FranzKugler/zynq-astro-guider/golden_model/rotation_sensitivity.png

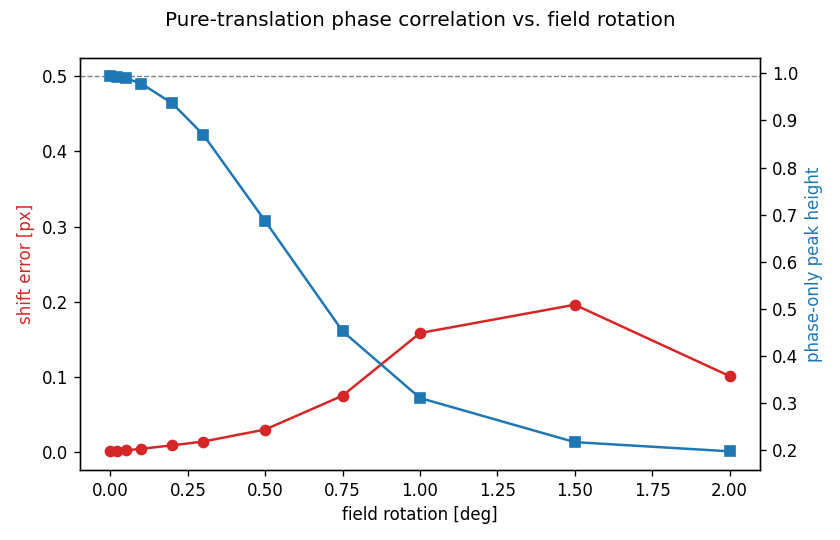
golden_model/rotation_sensitivity.png
