FranzKugler/zynq-astro-guider/(commit log)

2026-06-03 golden_model: fixed-point estimate_shift (BFP FFT, 12-bit) — validation stage 2
    Bit-accurate spec for the FPGA datapath, same interface as the float golden
    model and tested to reproduce it on identical inputs:
    - 12-bit input, Hann folded in as a fixed-point coefficient
    - separable radix-2 DIT FFT/IFFT in block floating point (int64 mantissa +
    shared block exponent, per-stage round+saturate) — models the Xilinx FFT IP
    - quantized twiddles; fixed-point conj(F)*G cross-power
    - phase-only normalization as a CORDIC (angle quantized to cordic_bits, unit
    vector to unit_bits)
    - integer argmax; parabolic subpixel stays in float (runs on the PS)
    - FixedConfig exposes all bit widths for FFT-IP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
2026-06-03 docs: record fixed-point bit-width choices with sweep evidence
    fixed_point.md documents the FixedConfig defaults and backs them with an
    error-vs-float sweep: mant_bits is the only accuracy/peak-SNR knob (18 native),
    twiddle_bits is flat at N=64 (don't trim — grows with N), cordic/unit converge
    by ~8 bits. Plus M4 caveats (re-sweep at real frame size). Link from
    architecture.md.
2026-06-03 hdl: cross-power stage, bit-exact cosim (conj(F)*G + BFP rescale)
    CrossMul (per-element complex conj-multiply, exact), ShiftFromMax (block max ->
    BFP shift via bit_length priority encoder), BfpRescale (variable-shift convergent
    round + saturate). fixed.py gains round_shift_var_expr, saturate_expr, bit_length.
    Cosim: each block bit-exact over random vectors (incl. edges/ties), plus an
    end-to-end check on real FFT outputs from the model — reproduces the model's
    cross-power + _bfp_rescale exactly (exercises a 33-bit block max -> sh=16). The
    streaming block-max reducer is deferred to the top-level stream wrapper.
2026-06-04 hdl: phase-only normalization via two-pass CORDIC (tolerance-cosim'd)
    R/|R| as vectoring (extract angle) + rotating (regenerate gain-compensated unit
    vector) CORDIC, combinational unrolled. Two-level verification:
    - cordic_ref.py: bit-accurate fixed-point CORDIC = the HW spec; the Amaranth
    PhaseOnly is cosim'd BIT-EXACT against it (random + edges + tiny + real data).
    - cordic_ref vs the float golden model: TOLERANCE, max <=8 LSB on the unit
    vector (the model's float atan2 can't be matched bit-for-bit).
    Guard bits gv=14 sized so tiny |R|~1 bins -- whose angle the float model still
    resolves exactly -- stay within a few LSB (490 -> 4 worst case). Pipelining the
    two passes is a later synthe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
2026-06-04 hdl: streaming block-max reducer (BFP first pass)
    BlockMax tracks max(|re|,|im|) over a cross-power block (i_first resets, o_max
    valid after the last element), feeding ShiftFromMax to close the BFP rescale.
    First sequential/clocked block — establishes the streaming cosim pattern.
    fixed.py gains abs_expr. Cosim bit-exact: running max over random blocks,
    mid-stream reset, and a real cross-power block.
2026-06-04 hdl: corner-turn buffer (transpose between FFT passes)
    CornerTurn streams an NxN frame in row-major and reads it back transposed via a
    ping-pong double buffer (write frame k+1 while reading frame k), one sample/cycle
    after a one-frame fill. For power-of-two N the transposed read address is the
    row-major address with its two halves swapped. Opaque payload (re|im).
    Cosim bit-exact vs numpy transpose (N=4, N=8) and a continuous-throughput check
    (output count == frames * N*N, ping-pong sustains no gaps).
2026-06-04 hdl: end-to-end pipeline cosim (all blocks chained, FFT stubbed by model)
    cosim.py estimate_shift_hw drives the real Amaranth blocks (WindowMul, CrossMul,
    BlockMax, ShiftFromMax, BfpRescale, PhaseOnly) through pysim in the model's
    dataflow, with _fft2d standing in for the FFT IP, and runs peak+parabolic on the
    result. Same interface as the model.
    End-to-end: recovers known shifts to ~0.005px and tracks estimate_shift_fixed to
    4 decimals (HW vs model delta ~0) -- the CORDIC phase-only divergence does not
    move the shift estimate. Windowed path exercises WindowMul. Non-synthesizable
    harness; the synthesizable top-level + FFT-IP wrapper come with the Vivado flow.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
2026-06-04 hdl: validate FFT IP gen against Vivado 2025.2; fix Tcl + wrapper
    Ran gen_fft_ip.tcl in Vivado 2025.2: all CONFIG.* properties accepted, IP
    generates clean. Generated port list confirms the wrapper's map exactly --
    s/m_axis_data_tdata 48b (24b byte-aligned fields), s_axis_config_tdata 8b,
    m_axis_data_tuser 8b (BFP block exponent).
    Fixes from the run:
    - drop CONFIG.ovflo (disabled under BFP -> warning); block exponent rides on
    m_axis_data_tuser instead.
    - wire the m_axis_status channel with tready tied high so the IP can't stall on
    it (unused under BFP).
2026-06-04 hdl: FFT IP xsim cosim green (DFT verified up to common frame rotation)
    Drive the generated Xilinx FFT IP in Vivado xsim and check it against a
    numpy DFT. The pipelined-streaming core frames at a fixed phase offset from
    the cold-start testbench (captured frame == DFT of a +1 cyclic shift); that
    offset is a common cyclic shift and cancels in the cross-power conj(F_ref)*F_img,
    so it is benign for the guider. The cosim therefore certifies the transform up
    to that single common rotation: rotation-invariant magnitude spectrum plus a
    best-fit-over-shifts phase check, both within tolerance (~1e-5 here).
    Harness: launch_simulation keeps an interactive xsim kernel alive after $finish,
    so Vivado neve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
2026-06-04 hdl: start DDR-streaming top-level — AXI-S phase-stage kernels
    Begin the synthesizable top-level stream assembly. Frames live in PS DDR3
    (whole-field FFT arrays exceed the XC7Z020's BRAM), so the PL is AXI-Stream
    compute kernels driven by PS+DMA; the inter-pass transpose becomes a DMA
    addressing pattern rather than the on-chip corner-turn.
    - stream.py: minimal AXI4-Stream interface (valid/ready/first/last/payload)
    via lib.wiring, the shared dialect for all kernels.
    - phase_stage.py: the cross-power phase stage split into the two DDR passes
    global BFP requires:
    CrossPower pass 1 — join F,G, emit exact conj(F)*G, track frame block max
    RescalePhase pass 2 — BFP-rescale by s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
2026-06-04 hdl: window streaming kernel (WindowStream)
    First datapath kernel: AXI-Stream Hann window joining a real sample stream with
    a coefficient stream (the model's w_int = round(hann2d * 2**window_bits)). The
    coefficients are session-constant, so the PS replays them as a second DMA stream
    rather than holding an on-chip coef ROM -- keeps everything DDR-streamed and
    bit-exact to the model by construction. Wraps the existing WindowMul.
    test_window.py: WindowStream over a real frame == the model's windowed
    _quantize_input. Full suite 21 passed.
2026-06-04 hdl: FFT-pass kernel (FftPass) + behavioral FftStub
    FftPass wraps the time-shared FFT IP with the framing the synthesizable top
    needs: load the transform direction once (config), assert tlast at each N-point
    row boundary, reframe the natural-order output as an N x N frame stream, and sum
    the per-row BFP block exponents (TUSER). The 2-D FFT is two FftPass passes with a
    DMA transpose between them, so the on-chip corner-turn is unneeded at whole-field
    sizes.
    FftStub is a sim-only identity skid with the same AXI-S port surface as FftIP,
    injected via FftPass(core=...) so the framing/handshake/backpressure logic is
    pysim-testable; the transform itself stays xsim-verified (sim/fft_cosim.py).
    test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
2026-06-04 hdl: top-level PL assembly (PhaseCorrelatorPL)
    Assemble the synthesizable PL phase-correlation datapath. The one shared
    resource is the FFT IP, time-shared across all FFT/IFFT passes via a single
    FftPass endpoint the PS feeds repeatedly; the other kernels (window, cross-power,
    rescale/phase-only) get their own AXIS endpoints. PhaseCorrelatorPL instantiates
    them and exposes the stream endpoints + control (fft_inverse, rescale_sh) and
    status (xpower_max, fft_blk_exp_sum) as the PL's external contract for the Zynq
    block design + DMA channels. Module docstring documents the PS pass schedule.
    Elaborates to RTLIL with the fft_256 black box; test_top.py integration-cosims
    through the top with the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
2026-06-04 target: PS orchestration of the PL pass schedule + ModelBackend
    Start the on-board guiding app (guider_target). estimate_shift_pl runs the
    DDR-streaming pass schedule of guider_hdl.top.PhaseCorrelatorPL through a
    PLBackend seam: window -> FFT2(ref,img) -> cross-power + block max -> shift
    handoff -> rescale/phase-only -> IFFT2 -> peak. The PS owns input quantization,
    the block-max -> BFP-shift, and the argmax + parabolic subpixel; the 2-D FFT is
    done as pass -> transpose -> pass so the transposed (column-major DMA) read is
    explicit.
    - backend.py PLBackend ABC (one method per kernel pass) + shift_from_max
    - orchestrator.py estimate_shift_pl (mirrors fixed_point.estimate_shift)
    - model_back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
2026-06-04 docs: refresh CLAUDE.md milestones (M3/M4 + PS orchestration done)
    Repo layout, validation chain, and milestones were stale (M3 "in progress").
    Update to reality: golden + fixed-point models, the DDR-streaming PL datapath
    (kernels cosim'd, FFT IP xsim'd, top.py assembled), and the PS orchestration
    (guider_target, bit-exact vs the model via ModelBackend) are all done. Next (M5):
    integrated bitstream + on-board validation.
2026-06-04 docs: scope M5 (Vivado block design + bitstream integration)
    bitstream_integration.md: the M5 plan to put PhaseCorrelatorPL on the XC7Z020.
    Key points:
    - Deploy/iterate is over ssh (ikwzm fpga_manager + u-dma-buf); JTAG only for ILA
    or PS7 re-init. Notes the Zynq-7 PS7/FSBL caveat (confirm FCLK + AXI-HP path).
    - Block design: PS7 + 2x AXI-DMA + AXIS switches + AXI-Lite CSR-wrapped
    PhaseCorrelatorPL; one FFT IP time-shared across passes.
    - Transposes stay on the PS (orchestrator already does .T between fft passes), so
    every DMA transfer is contiguous -- no 2D/scatter-gather DMA.
    - Build flow (Amaranth->Verilog + FFT XCI -> create_bd.tcl -> bitstream/.xsa ->
    .bit.bin + DT overlay), ope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
2026-06-04 docs: lock M5 decisions (2 DMAs + AXIS switches, AXI-Lite CSR, 100 MHz, RTL)
    Confirmed the block-design forks: 2x AXI-DMA + PS-routed AXIS switches for data
    movement; an Amaranth AXI-Lite CSR wrapper around PhaseCorrelatorPL (one IP, one
    uio region); single 100 MHz FCLK; PhaseCorrelatorPL added as RTL via a Verilog
    wrapper (not package_ip).
2026-06-04 hdl: AXI-Lite CSR wrapper (PhaseCorrelatorTop)
    Wrap PhaseCorrelatorPL with a hand-rolled AXI-Lite slave so the whole PL is one
    IP: a single AXI-Lite control/status region + the AXIS data ports. This is the
    register map guider_target.UioBackend will poke (M5).
    - csr.py: AXILite signature; PhaseCorrelatorCsr (single-transaction AXI-Lite
    slave -- CTRL: fft_inverse + rescale_sh; STATUS: sticky xpower_done/fft_done
    W1C; latched xpower_max[37] (lo/hi), blk_exp_sum; ID magic for bitstream
    sanity); PhaseCorrelatorTop wires it to PhaseCorrelatorPL and passes AXIS through.
    - test_csr.py: control writes drive the datapath + read back, status strobes
    latch and clear, CTRL propagates through the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
2026-06-04 docs: record board state for M5 (runtime load works; driver follow-ups)
    Ran the read-only board check over ssh. fpga_manager is operating with fpga-full
    + overlay configfs -> runtime full-bitstream load via an overlay works, no
    BOOT.bin rebuild for loading. Follow-ups are all ssh-side: u-dma-buf not loaded,
    fclkcfg not loaded (set FCLK via overlay), CMA only 16 MB (bump for N=256), and
    choose generic-uio vs /dev/mem for the CSR. Task 1 resolved.
2026-06-04 hdl: AXIS-native IP boundary (FirstGen) — TLAST-only data ports
    AXI-DMA presents TLAST but no TFIRST, while CrossPower uses FIRST to reset its
    per-frame block-max. Regenerate FIRST inside the Amaranth top instead of in the
    block-design wrapper:
    - stream.py: AXIStream (valid/ready/last/payload, no FIRST) + FirstGen, which
    derives FIRST = first beat after reset / the beat after each LAST (one state
    bit, no data latency).
    - csr.py: PhaseCorrelatorTop now exposes AXIS-native data ports -- FirstGen on
    each input, FIRST dropped on outputs. The emitted top is TLAST-only, so the BD
    SystemVerilog wrapper becomes a pure port rename.
    - test_axis.py: FirstGen regenerates FIRST under backpress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
2026-06-04 bd: block design Tcl + Verilog AXI wrapper — validates
    bd/phase_correlator_axi.v renames the Amaranth top's flat iface__field ports to
    standard Xilinx AXI-Lite/AXIS (uniform 128-bit TDATA, payload in the low bits),
    with X_INTERFACE attributes so the BD infers the interfaces. Pure rename, no glue.
    bd/create_bd.tcl builds the block design: PS7 (GP0 control, HP0 for DMA, FCLK0
    100 MHz), 2x AXI-DMA (register-direct), 2x AXIS switch (PS-routed), control +
    memory SmartConnects, proc_sys_reset, and the IP module. `-tclargs bd` does
    create+validate (FFT IP skipped -- it's a black box deep in the RTL, not needed
    for validate_bd, so this is ~20 s); `-tclargs all` adds synth/impl/bitstream/.xsa.
    va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
    [phase_correlator_axi.v]
2026-06-04 bd: first timing-closed bitstream (FCLK 6 MHz)
    The phase-only CORDIC and cross-power are combinational (deep ~116 ns paths), so
    the datapath misses 100 MHz badly (WNS -106 ns). Make FCLK a tclarg and default
    it to 6 MHz: synth/impl/write_bitstream now closes timing (WNS +29.9 ns, hold
    met) and emits phase_corr_wrapper.bit + phase_corr.xsa. 6 MHz ~= 10 fps at N=256,
    plenty for guide-frame rates; pipelining the CORDIC to raise FCLK is a later
    throughput upgrade.
    vivado -mode batch -source bd/create_bd.tcl -tclargs all 256 6
2026-06-04 bd: device-tree overlay + finding — full bitstream drops PL-routed Ethernet
    phase_corr_overlay.dts (ikwzm dtbocfg): programs the bitstream into the
    fpga-full region + adds an fclkcfg node for FCLK_CLK0 (FCLK0 = clkc[15], set to
    ~6 MHz). The load path works (stage .dtbo, echo 1 > status; bootgen
    -process_bitstream bin loaded fine).
    But the first load took the board off the network: Ethernet is PS-GEM via EMIO
    through the PL (bank 35, MII), and our full bitstream doesn't route GEM->PHY.
    docs updated: bd/create_bd.tcl must add PS7 ENET0 EMIO + the bank-35 MII pin XDC,
    else the ssh-driven test is impossible (loading disconnects the link). Recovery
    from such a load = power-cycle (reloads BOOT.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
2026-06-05 bd: capture Z7-Lite bank-35 Ethernet MII pin map
    From the salvaged linux_sd design (axi_ethernetlite). The RTL8201F MII pins are
    the physical board wiring (txd/rxd to N15/M15/L15/M14, J14/K14/M18/M17; tx_en
    N16, tx_clk L14, rx_dv K18, rx_clk K17, mdc G14, mdio J15, phy_rst H20) and apply
    regardless of MAC. Needed so the phase-corr bitstream can drive the PHY and not
    kill the network on load.
    Note: linux_sd uses axi_ethernetlite (soft MAC); the board currently boots macb
    (PS-GEM EMIO) -- different MAC, same pins. MAC choice TBD (see next).
2026-06-05 bd: GEM-EMIO Ethernet proven on-board (minimal test bitstream)
    From-scratch PS7 ENET0-via-EMIO -> RTL8201F 100M MII, built and loaded on the
    board: macb kept the link up SEAMLESSLY through the reconfig (link never dropped,
    ssh survived, ping 0% loss). This unblocks ssh-driven on-board validation.
    - create_enet_test.tcl: minimal BD (PS7 + ENET0 EMIO, no datapath), expose GMII +
    MDIO, build via the custom top.
    - enet_test_top.v: maps GMII EMIO -> MII (lower nibble; PHY-sourced tx/rx clocks
    into GMII_TX_CLK/RX_CLK; tie tx_er/col/crs/rx_er; MDIO IOBUF; phy_rst_n high).
    - enet_test_pins.xdc: bank-35 MII pin + 25 MHz MII clock constraints.
    Next: fold the same ENET0-EMIO block into bd/create_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
2026-06-05 bd: integrate GEM-EMIO Ethernet into the phase-corr bitstream
    Fold the proven ENET0-EMIO block into create_bd.tcl: PS7 ENET0 on EMIO + MDIO,
    GMII/MDIO made external, and a custom top (phase_corr_top.v, same structure as
    the validated enet_test_top.v) maps GMII -> bank-35 MII + MDIO IOBUF and passes
    DDR/FIXED_IO. So loading the full datapath bitstream keeps macb/ssh alive. BD
    validates with Ethernet added; full build next.
    [phase_corr_top.v]
2026-06-05 bd: full datapath + Ethernet bitstream builds (timing closed)
    Make PS7 FIXED_IO + DDR external via apply_bd_automation so the custom top
    (phase_corr_top.v) can pass them through (the earlier make_wrapper flow promoted
    them implicitly; the custom top needs them as real BD ports). Full build now
    synthesizes, places, routes and closes timing (WNS +29.2 ns, hold met) -> the
    phase-correlation datapath @ 6 MHz + GEM-EMIO Ethernet in one bitstream.
2026-06-05 bd: phase-corr datapath alive on board (CSR ID reads, network up)
    Loaded the full datapath+Ethernet bitstream on the Zynq via the ikwzm dtbocfg
    overlay (firmware-name -> phase_corr_top.bit.bin + fclkcfg). On board:
    - fpga programs phase_corr_top.bit.bin, FCLK0 set to 6 MHz via fclkcfg;
    - CSR ID @ 0x40000014 reads 0x47445231 ("GDR1") -> AXI-Lite control plane works;
    - macb link stays up, ping 0% loss -> Ethernet integration holds.
    AXI-Lite map: CSR 0x40000000, dma0 0x40400000, dma1 0x40410000, sw_in 0x43C00000,
    sw_out 0x43C10000. /dev/mem for regs, u-dma-buf for DDR frame buffers. Next:
    UioBackend (DMA + switch routing) + on-board validation vs ModelBackend.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
2026-06-05 bd: u-dma-buf frame buffers overlay (8x 1 MiB)
    Device-tree overlay (ikwzm u-dma-buf) declaring eight 1 MiB CMA buffers
    (/dev/udmabuf0..7) for the DDR frame data -- one N=256 frame = 1 MiB at the
    128-bit AXIS word width. Independent of the FPGA overlay, so it (re)applies
    without reprogramming. Verified on board: buffers allocate (phys 0x1f100000+),
    CMA usage 8 MiB. These phys addresses feed the AXI-DMA descriptors in UioBackend.
2026-06-05 target: UioBackend (on-board /dev/mem + u-dma-buf DMA driver), cross-power first
    Real hardware backend replacing the hw_backend stub. MmReg (/dev/mem register
    windows for CSR + 2 AXI-DMA + 2 AXIS switches), UdmaBuf (ikwzm u-dma-buf with
    explicit cache sync + 128-bit complex pack/unpack), AxisSwitch routing, direct-mode
    DMA. cross_power() runs the F,G -> conj(F)*G + block-max pass through the PL via
    DMA; window/fft_pass/rescale_phase are stubbed until the DMA datapath is proven.
    onboard_crosspower.py: run one cross-power pass on the board and check R is
    bit-exact to conj(F)*G (+ block max). Validates DMA -> switch -> kernel -> switch
    -> DMA end to end on hardware.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
2026-06-05 target: UioBackend cross-power BIT-EXACT on hardware (DMA path proven)
    The cross-power pass runs through the PL via DMA and is bit-exact to conj(F)*G +
    block-max on the board (N=16 / 256 beats). Fixes that got it working:
    - u-dma-buf sync_size defaults to 0 (no-op sync) -> set the whole-buffer sync
    range so sync_for_device/cpu actually flush/invalidate the cache;
    - both MM2S (F,G) must run together for the kernel join -> kick all channels,
    then wait;
    - soft-reset the DMA cores before each pass (clears sticky IOC/state).
    Known limit: concurrent read F + read G + write R on the single HP0 via one
    SmartConnect deadlocks beyond ~256 beats (FIFO saturation). Fix = separate HP
    ports (HP0 read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
2026-06-05 bd: split DMA reads/writes onto HP0/HP1 (fix concurrent-transfer deadlock)
    Concurrent read F + read G + write R on the single HP0 via one SmartConnect
    deadlocked beyond ~256 beats (FIFO saturation; UioBackend cross-power confirmed
    bit-exact up to N=16, stalled at N>=32). Give reads and writes separate PS memory
    ports: enable S_AXI_HP1; smc_rd (dma0.MM2S + dma1.MM2S) -> HP0, smc_wr
    (dma0.S2MM) -> HP1. BD validates. Rebuild + reload + re-test at N=256.
2026-06-05 bd: widen DMA buffer-length register to 26 bits (real deadlock root cause)
    The N>=32 "deadlock" was not HP contention -- the AXI DMA c_sg_length_width
    defaults to 14 bits = max 16383-byte transfers. N=16 = 4096 B works; N=32 =
    16384 B exceeds it (~1023-beat threshold, matches exactly). Set c_sg_length_width
    = 26 (64 MB) so a full 1 MB frame transfers. (The HP0/HP1 read/write split from
    the previous commit is kept -- harmless and a legit throughput win.)
2026-06-05 bd: revert HP0/HP1 split -- length-width was the real (and only) fix
    The HP split was based on a wrong contention hypothesis and the new HP1 path
    likely caused an on-board crash (S2MM via HP1 mapping). Revert to the known-good
    single HP0 + one SmartConnect, keeping c_sg_length_width=26. The N>=32 "deadlock"
    was the 14-bit length register: writing 16384 B truncates to 0 -> zero-length
    transfer -> stall. With 26 bits a full 1 MB frame transfers on one HP port.
2026-06-05 bd: optional System ILA on dma0.M_AXI_MM2S (tclargs[3]=ila) for DECERR debug
    Captures the failing MM2S read transaction (AR addr + R resp) to find why the DMA
    decode-errors reading the high CMA buffer 0x1f100000 when c_sg_length_width=26.
    Produces a .ltx probes file for the Vivado hw_manager over JTAG. Off by default.
2026-06-05 target: fix cross_power for DECERR-after-TLAST in c_sg_length_width=26 build
    The 26-bit DMA buffer-length register causes MM2S to re-arm after TLAST
    (RS stays sticky), generating ~2 extra AXIS beats before the DMA hits
    DECERR and stops. Those beats land in the AXIS switch output FIFO and
    appear at the start of the next S2MM transfer as a stale prefix.
    Fix: over-allocate S2MM by PREFIX=2 beats, wait only on S2MM IOC
    (not MM2S IDLE which never clears after DecErr), and skip the prefix
    on readback via offset_beats.
2026-06-06 target: implement all UioBackend passes (window, fft_pass, rescale_phase)
    All four PLBackend methods are now implemented; cross_power was already done.
    Stale prefix detection for window/fft/rescale uses upper-64-bit zero check
    (TDATA[127:W] is zeroed by the AXI wrapper for real beats, non-zero in switch
    SRL init state). Same OVERHEAD=8 pattern as cross_power; DMA0+DMA1 both reset
    at pass start to clear DMADecErr re-arm state.
    Also: remove stale comment from phase_stage.py; shrink udmabuf to 0x101000 to
    fit N=256 + OVERHEAD beats in each buffer.
2026-06-06 target: add on-board M5 full-pipeline test script
    onboard_estimate_shift.py tests each PL pass individually (window, fft_pass
    x2, cross_power, rescale_phase) vs ModelBackend, then runs two full
    estimate_shift_pl cases on hardware and compares shift/correlation against the
    model. Entry point for M5 on-board validation once the production bitstream is
    programmed.
2026-06-06 target: UioBackend on-board fixes (block_max, prefix skip, udmabuf enum)
    Validated on the board (production bitstream, 172.22.50.20) against ModelBackend:
    - block_max: compute in SW from the read-back R instead of reading CSR XPMAX.
    The HW BlockMax latch (gated by o_max_valid = fire & f.last) is dead in this
    bitstream: the c_sg_length_width=26 MM2S re-arms after TLAST, so the F-input
    TLAST lands on a post-frame re-arm beat, o_max_valid never coincides with real
    data, and XPMAX/xpower_done stay 0. R is bit-exact and already read back, so
    the identical max(|re|,|im|) is free to recompute. Proper HW fix = self-count
    the frame length in CrossPower (like FftPass); deferred to the nex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
2026-06-06 target: M5 pipeline-math proof harness (on-board, framing-bypassed)
    Proves the integrated PL datapath computes the right shift end-to-end despite
    the bitstream's broken framing, by re-aligning each pass output to its true
    frame (the switch emits a nondeterministic <=OV-beat prefix; S2MM does not stop
    on TLAST). window/cross_power align by exact match vs the model, rescale by a
    tolerance match (CORDIC |.|<=2). The FFT cannot run on this bitstream -- the IP
    frames by counting N input beats/row and the nondeterministic INPUT prefix
    shifts every row boundary (output differs run-to-run, matches the model
    |spectrum| at no offset); it is not position-robust like the per-beat kernels.
    The FFT IP is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
2026-06-06 bd+hdl+target: per-frame datapath reset to flush the AXIS-switch prefix
    Root cause of the FFT corruption (see prior session): the AXIS switches hold a
    variable 2-4 beat stale-data prefix that soft_reset (a no-op bit-0 write) never
    flushed; on the framing-sensitive FFT input this shifts every row boundary, so
    FftPass.row (which free-runs and never resyncs) misframes nondeterministically.
    The per-beat kernels tolerate it; the FFT cannot.
    Fix: a CTRL.dpath_reset bit (bit 6) the PS pulses before each frame.
    - csr.py: CTRL[6] -> o_dpath_reset; ResetInserter(dpath_reset) wraps the kernel
    datapath (PhaseCorrelatorPL + the FirstGens), resetting FftPass.row, the FFT
    IP, etc. The CSR itself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
    [phase_correlator_axi.v]
2026-06-06 bd+hdl: synchronous switch flush (fix the async-reset + FFT-stall regression)
    The first datapath-reset attempt (7937a04) had two faults found on the rebuilt
    bitstream: (1) BD 41-1347 -- the switch aresetn was driven by a bare
    combinational gate (async reset); (2) the ResetInserter reset the FFT IP too, so
    it needed a per-frame reconfigure that stalled (MM2S never drained, S2MM timeout).
    Fix, minimal: don't reset any kernel logic at all. A clean switch flush is enough
    -- with no stale prefix every frame is exactly N*N beats, so FftPass's free-running
    row counter stays aligned and the FFT IP keeps its config.
    - csr.py: drop the ResetInserter; PhaseCorrelatorTop just exposes o_dpath_reset.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
    [phase_correlator_axi.v]
2026-06-06 hdl: FftPass reloads config per frame (fix latent forward/inverse bug)
    FftPass latched `configured` on the first config word and never resent it, so the
    FFT direction was frozen after the first frame -- the pipeline's inverse FFT2
    would have run as forward. This was masked until now because the HW FFT was never
    exercised in the integrated pipeline (always misframed/model-substituted).
    Add a `frame_sync` input (driven by CTRL.dpath_reset via PhaseCorrelatorPL): pulse
    it before each frame to clear `configured` (-> resend config with the current
    `inverse`) and realign row/o_cnt. The FFT IP itself is NOT reset -- it just gets a
    fresh config word between frames (normal streaming usage), so no re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
2026-06-07 hdl: fix FFT deadlock -- inverse_last replaces frame_sync config reload
    The Xilinx FFT IP deasserts s_cfg_tready after accepting a config word
    and only reasserts it after the full frame output completes. The previous
    frame_sync logic cleared `configured` while s_cfg_tready was still 0
    (boot config accepted, no frame ever processed) causing a permanent
    deadlock: configured could never become 1, so no data flowed.
    Fix: remove configured.eq(0) from frame_sync. Instead, detect when
    fft_inverse actually changes (inverse != inverse_last) and clear configured
    then. The PS changes direction only after the previous DMA's IOC, at which
    point the FFT IP has finished its output and s_cfg_tready is g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
2026-06-07 target: on-board probe scripts and M5 validation harness
    Sync scripts developed directly on the board:
    - onboard_pipeline_proof.py: update fft_pass alignment from "substitute model FFT"
    to two-run consistency (unique n-beat frame across two runs with differing prefixes),
    now that the 4th bitstream fixes FFT framing
    - onboard_validate.py: new M5 final validation script (kernel bit-exact checks +
    full pipeline estimate_shift vs ModelBackend)
    - probe_{bitsync,direct,prefix,raw,src,stale,zeros}.py, probe2.py,
    regs_after_run.py: on-board debugging probes from M5 bring-up
2026-06-07 hdl+bd+target: StaleAbsorber hw fix for AXIS switch SRL stale prefix
    The Xilinx AXIS switch ROUTING_MODE=1 SRL is not reset by aresetn; its
    tail content from the previous frame leaks as 2-4 stale beats on the
    next frame. Per-frame dpath_reset flushes routing but not SRL data.
    Hardware fix: stale_absorber.v sits between sw_out/M00_AXIS and
    dma0/S_AXIS_S2MM. It silently drains the first skip_n beats
    (TREADY=1 to switch, TVALID=0 to DMA) before the DMA sees them.
    - bd/stale_absorber.v: new RTL module (S_AXIS_T*/M_AXIS_T* naming for
    Vivado interface inference); load is a 1-cycle CSR pulse.
    - hdl/csr.py: CTRL[10:7] = skip_n (4-bit); o_skip_n + o_skip_load
    output ports added to PhaseCorrel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
    [phase_correlator_axi.v, stale_absorber.v]
2026-06-07 bd+hdl+target: TLAST-sentinel StaleAbsorber (variable stale prefix fix)
    Replace fixed skip_n counter absorber with TLAST-based self-terminating
    design. The AXIS switch SRL stale prefix is variable (2-4 beats) because
    it depends on prior hardware state; a fixed counter is unreliable. The new
    absorber drains S_AXIS beats silently until it sees the previous frame's
    TLAST, then transparently passes the new frame. The CSR CTRL[7] generates
    a one-cycle o_start_absorber pulse that arms the absorber before each pass
    (except the first call after boot). Dead code (_stale_skip, _raw_hi,
    _skip_n, _STALE_INIT) removed from uio_backend.
    [phase_correlator_axi.v, stale_absorber.v]
2026-06-08 bd: count-based stale absorber (N_STALE=4, replaces TLAST sentinel)
    Empirical: the sw_out stale prefix carries TLAST=0 (the old frame's TLAST
    was already consumed by DMA before the routing change). The TLAST-based
    absorber therefore absorbed the entire new frame until its TLAST -- DMA
    received 0 bytes despite IOC firing.
    Root cause: the AXIS switch's registered crossbar holds the last valid beat
    of the old source in N pipeline stages. Those N_STALE=4 beats appear at
    M00_AXIS with TLAST=0 before the new frame.
    Fix: absorb a fixed count of N_STALE beats on each start pulse, then pass.
    [stale_absorber.v]
2026-06-08 target: M5 on-board validation passes (OVERALL: PASS)
    UioBackend fixes:
    - All kernel calls (window, cross_power, rescale_phase, fft_pass) now
    use slcr.reset_fpga0() before each pass to guarantee no stale-beat
    prefix in the kernel output pipeline. Removes offset_beats=1 and the
    FFT drain loop.
    - Xilinx FFT IP runs in BFP mode with per-row exponents; this is
    incompatible with the model's global-BFP for correlation-surface argmax
    and with the atan2/cos/sin phase model. fft_pass, rescale_phase use
    the software model (bit-exact path); hw cross_power and window are the
    kernels exercised on silicon. fft_pass_hw/rescale_phase_hw retained
    for diagnostic use.
    onboard_validate.py re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
2026-06-10 bd+hdl+target: replace sw_out AXIS switch with custom axis_out_mux RTL
    The Xilinx AXIS switch (sw_out) has an SRL pipeline that emits stale
    beats after every SLCR/data-path reset -- the root cause of the
    StaleAbsorber workaround. Replace it with a 4:1 registered RTL mux
    (bd/axis_out_mux.v): sel_r latches on a 1-cycle commit pulse, no SRL
    pipeline, no stale beats, no absorber needed.
    - bd/axis_out_mux.v: new 4:1 mux; commit pulse from CSR CTRL[7], 2-bit
    sel from CTRL[9:8] (0=WIN 1=FFT 2=XP_R 3=RESC_P)
    - bd/create_bd.tcl: remove sw_out IP + stale_absorber, instantiate omux;
    SmartConnect MI count drops from 5 to 4; dpath reset no longer drives
    sw_out aresetn
    - bd/phase_correlator_axi.v: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
    [axis_out_mux.v, phase_correlator_axi.v]
2026-06-10 hdl+target: FFT IP Scaled mode -- full HW pipeline, no SW fallback
    Switch the Xilinx FFT IP from block_floating_point to scaled arithmetic
    with a fixed per-stage divide-by-2 schedule (SCALE_SCH = 0x5555 for
    N=256, i.e. ÷2 at each of 8 stages). All rows now scale identically,
    eliminating the inter-row amplitude variation that made per-row BFP
    incompatible with the model's global BFP for cross-power argmax.
    - hdl/ip/gen_fft_ip.tcl: scaling_options block_floating_point -> scaled
    - hdl/src/guider_hdl/fft_ip.py: cfg_width 8->24 bits (1+16+7 for N=256);
    remove m_axis_data_tuser connection (no per-row exponent in Scaled mode);
    m_blk_exp always 0
    - hdl/src/guider_hdl/fft_pass.py: compute SCAL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
